ChristianBZG/openclassrooms-TP1-github/README.md

# openclassrooms-TP1-github
Ce repository contient trois fichiers, un PNG donnant un schéma de montage n'ayant aucun rapport avec le projet (juste pour essai), un PDF qui explique un montage de va et vient pour train miniature, un INO qui est le programme pour une carte Arduino Uno.

Ces deux derniers fichiers sont suffisants pour réaliser ce montage qui est très simple.

Le montage a déjà été publié dans Loco-Revue, et est totalement open-source.

A vous de jouer...

J'avais oublié un message de validation du commit
