ChristianBZG/openclassrooms-TP1-github/Figure 5.png

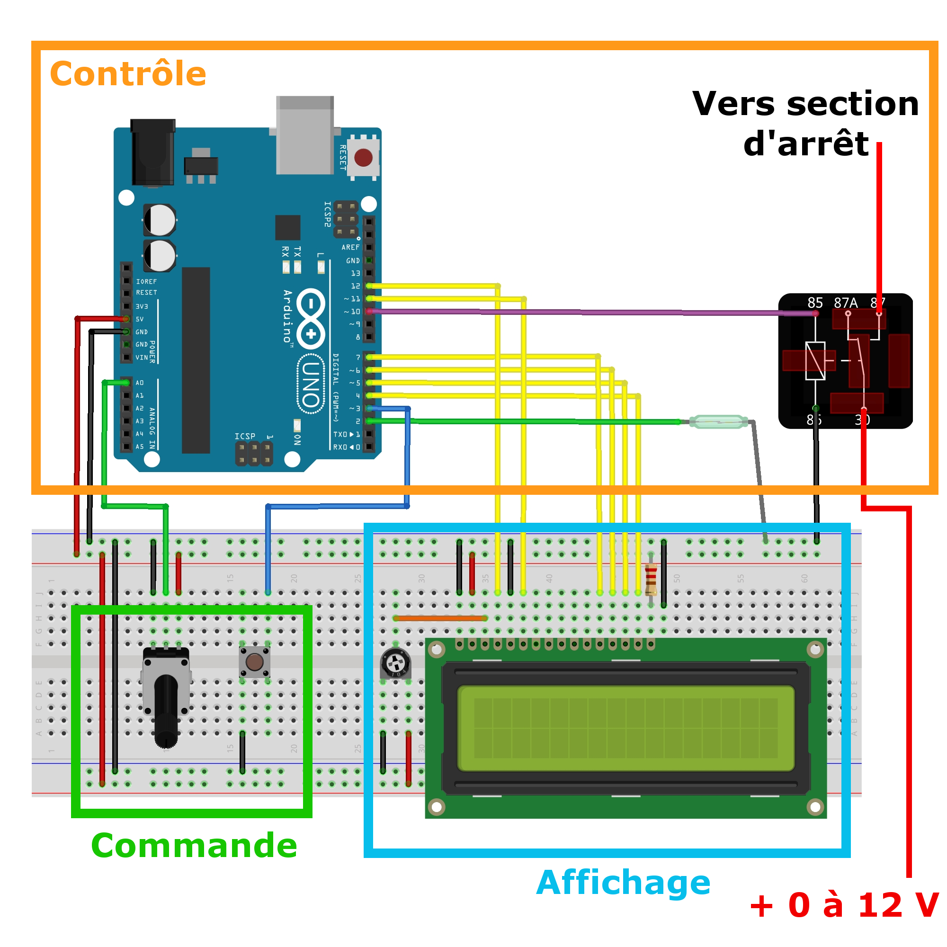
Figure 5.png
