ChristianBZG/openclassrooms-TP1-github/(commit log)

2018-01-07 Ajout d'un fichier PDF
    Ce PDF explique le montage de va et vient analogique pour train miniature à base d'Arduino Uno
2018-01-07 Ajout d'un fichier .INO
    Ce fichier est le programme en C pour la carte Arduino Uno
2018-01-07 Explication des deux fichiers PDF et INO
2020-10-09 Update README.md
    Message de changement
